kukas/48Knobs/pcb/48knobs_schematics.pdf

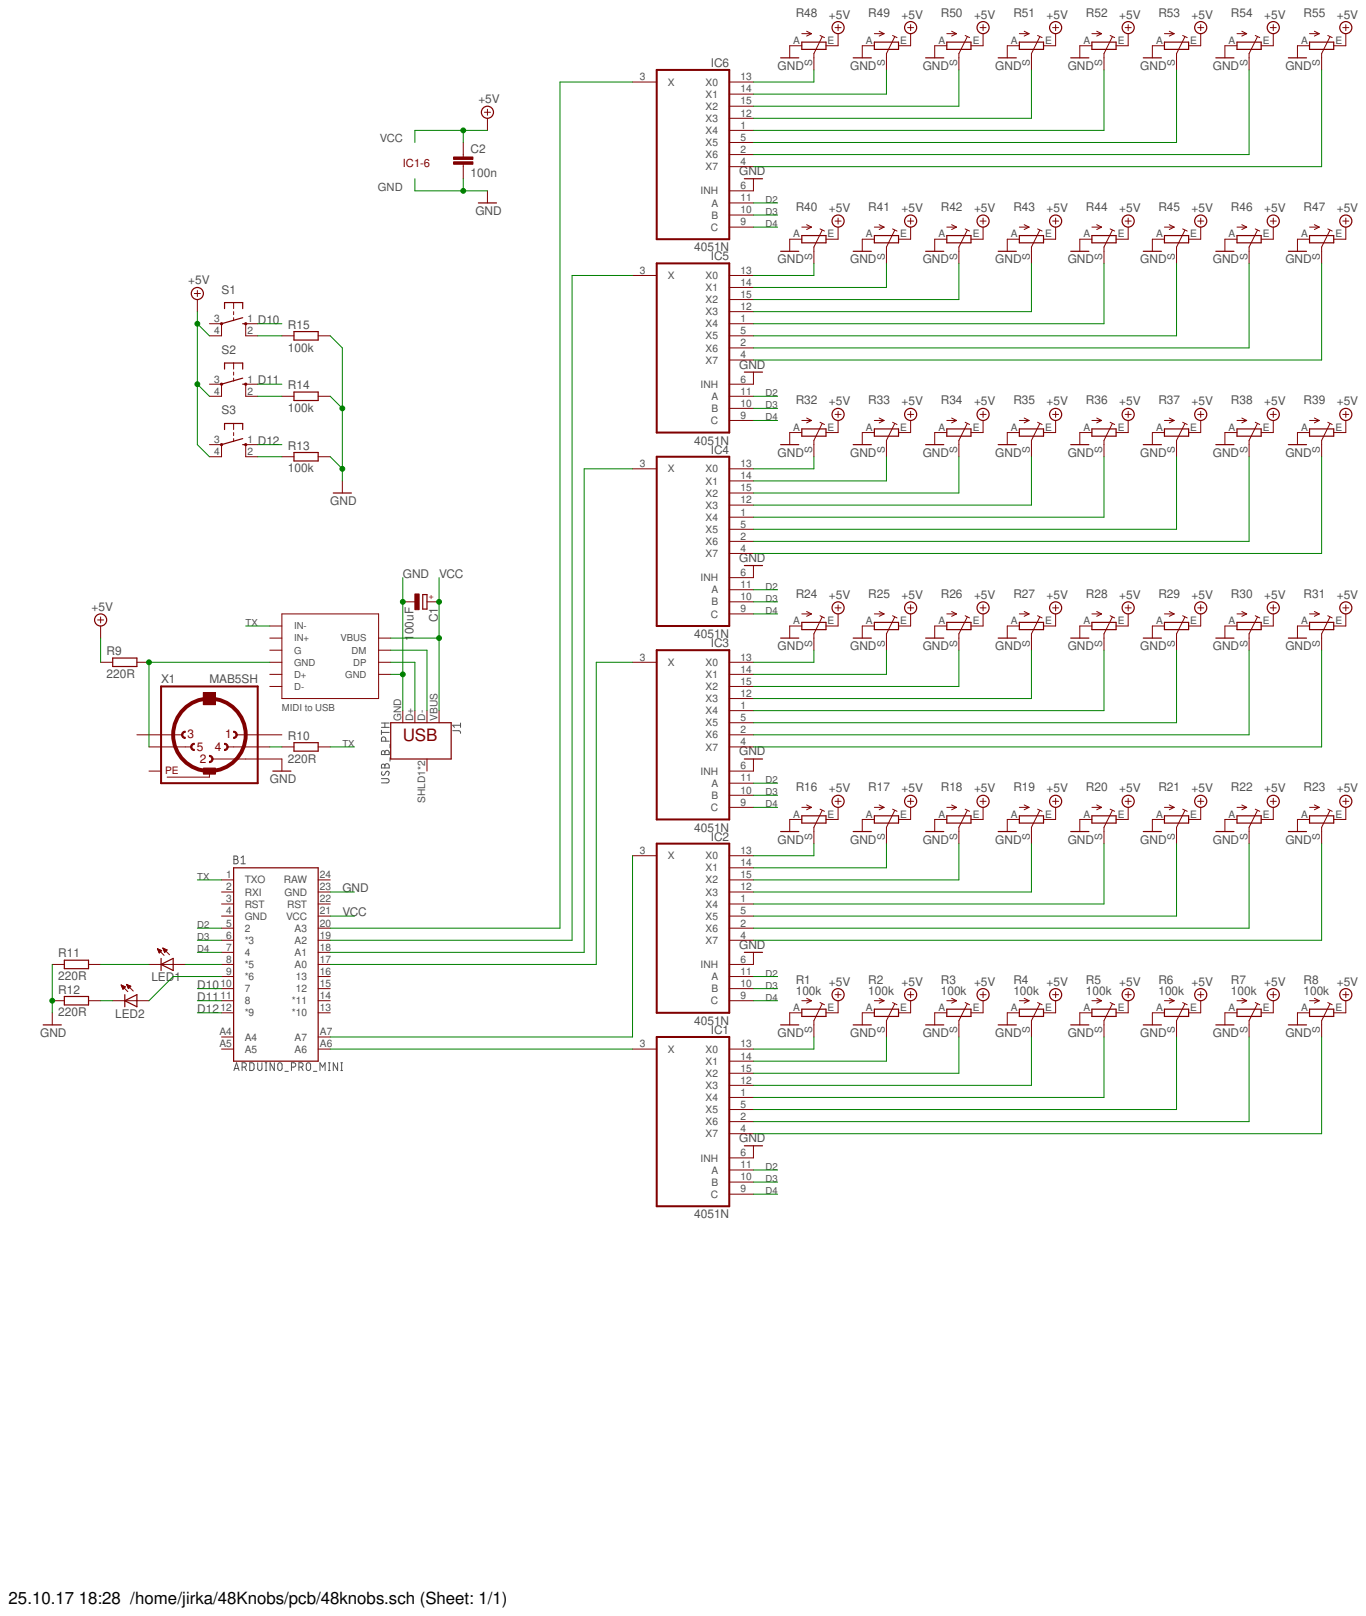
[picture p3: page 1]

25.10.17 18:28 /home/jirka/48Knobs/pcb/48knobs.sch (Sheet: 1/1)
