kukas/48Knobs/(list of files, drawings)

Other design files:
pcb/48knobs_pcb.lay6
