kukas/48Knobs/pcb/48knobs_schematics.sch

## EAGLE design pcb/48knobs_schematics.sch (2017-10-25)

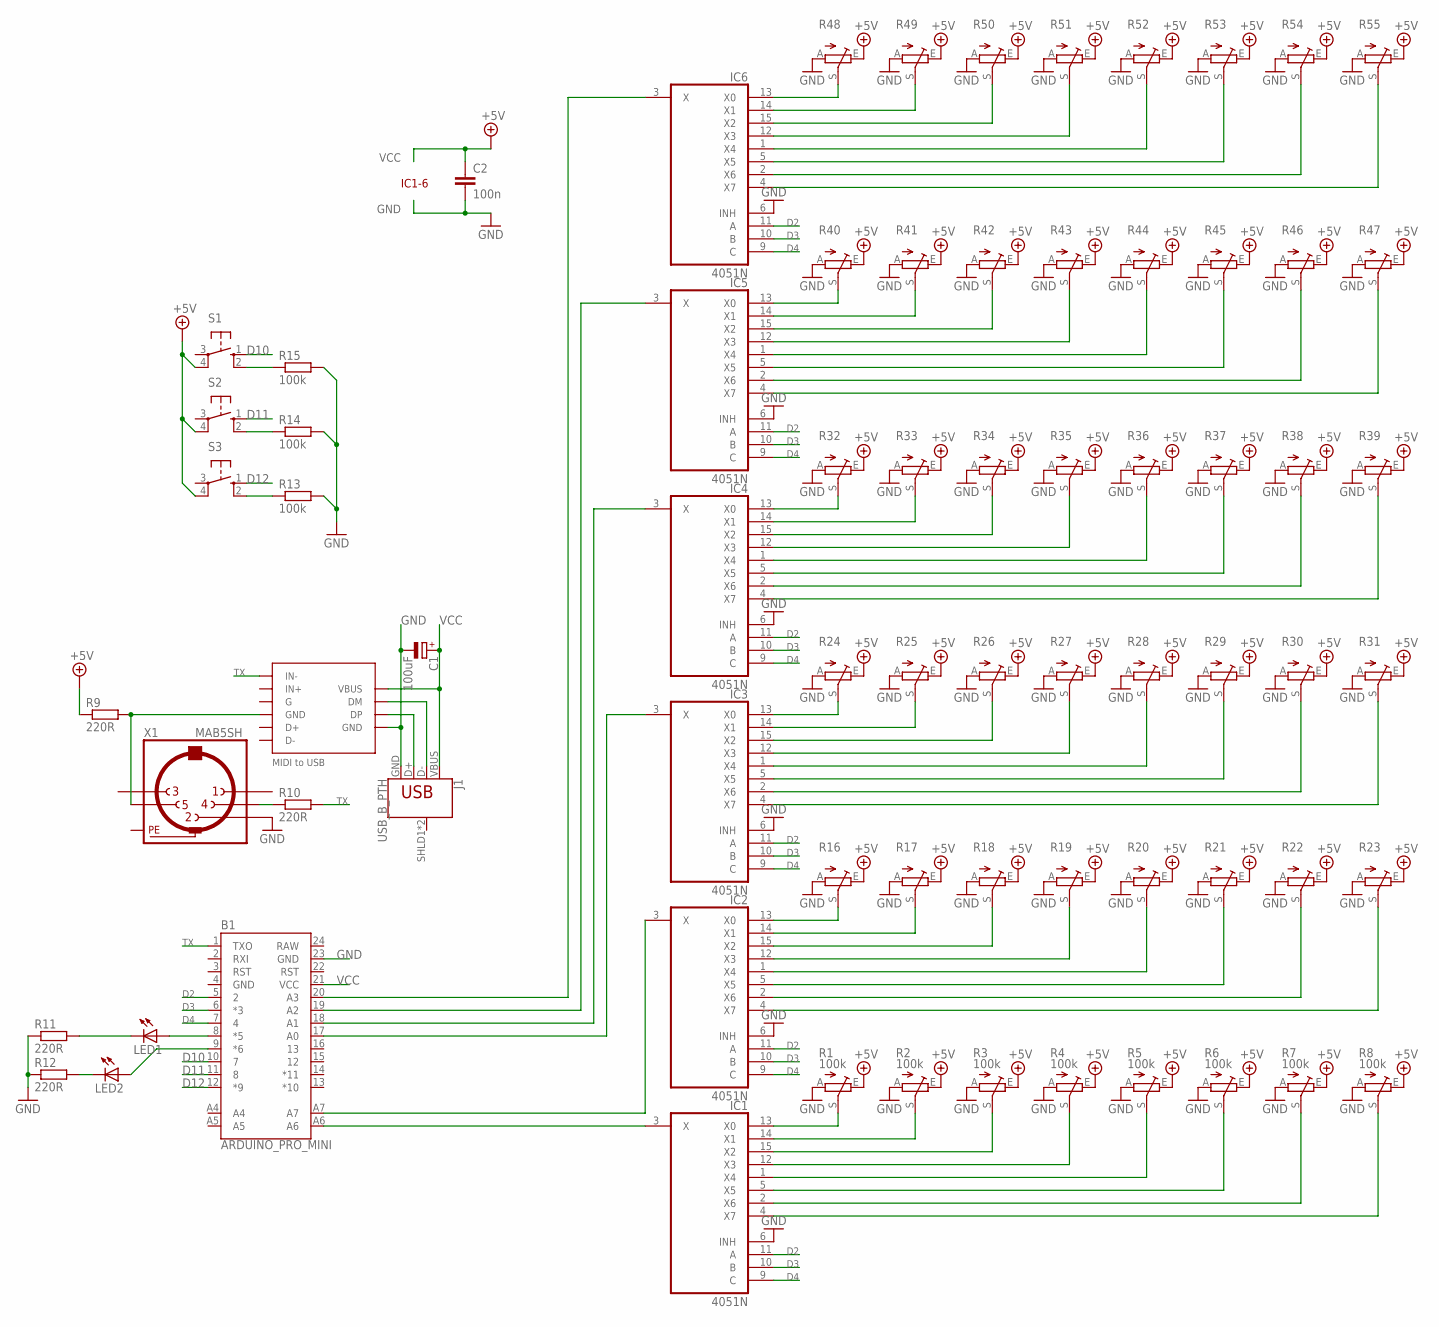
[picture p4: schematic 48knobs_schematics.sch]

Parts:
B1: ARDUINO_PRO_MINI
C1: 100uF; E1,8-4
C2: 100n; C2.5-3
IC1, IC2, IC3, IC4, IC5, IC6: 4051N; DIL16
J1: USB_B_PTH; USB-B-PTH
LED1, LED2: LED3MM
R1, R2, R3, R4, R5, R6, R7, R8: 100k; B25U
R9, R10, R11, R12: 220R; 0204/5
R13, R14, R15: 100k; 0204/5
R16, R17, R18, R19, R20, R21, R22, R23, R24, R25, R26, R27, R28, R29, R30, R31, R32, R33, R34, R35, R36, R37, R38, R39, R40, R41, R42, R43, R44, R45, R46, R47, R48, R49, R50, R51, R52, R53, R54, R55: TRIM_EU-B25U; B25U
S1, S2, S3: 10-XX; B3F-10XX
X1: MAB5SH

Connections:
+5V: R1.E, R2.E, R3.E, R4.E, R5.E, R6.E, R7.E, R8.E, R9.1, R16.E, R17.E, R18.E, R19.E, R20.E, R21.E, R22.E, R23.E, R24.E, R25.E, R26.E, R27.E, R28.E, R29.E, R30.E, R31.E, R32.E, R33.E, R34.E, R35.E, R36.E, R37.E, R38.E, R39.E, R40.E, R41.E, R42.E, R43.E, R44.E, R45.E, R46.E, R47.E, R48.E, R49.E, R50.E, R51.E, R52.E, R53.E, R54.E, R55.E, S1.4 (P1), S2.4 (P1), S3.4 (P1)
D2: B1.5 (2), IC1.11 (A), IC2.11 (A), IC3.11 (A), IC4.11 (A), IC5.11 (A), IC6.11 (A)
D3: B1.6 (*3), IC1.10 (B), IC2.10 (B), IC3.10 (B), IC4.10 (B), IC5.10 (B), IC6.10 (B)
D4: B1.7 (4), IC1.9 (C), IC2.9 (C), IC3.9 (C), IC4.9 (C), IC5.9 (C), IC6.9 (C)
D10: B1.10 (7), S1.1 (S)
D11: B1.11 (8), S2.1 (S)
D12: B1.12 (*9), S3.1 (S)
GND: B1.23 (GND), C1.-, C2.2, IC1.6 (INH), IC2.6 (INH), IC3.6 (INH), IC4.6 (INH), IC5.6 (INH), IC6.6 (INH), J1.GND, R1.A, R2.A, R3.A, R4.A, R5.A, R6.A, R7.A, R8.A, R11.1, R12.1, R13.2, R14.2, R15.2, R16.A, R17.A, R18.A, R19.A, R20.A, R21.A, R22.A, R23.A, R24.A, R25.A, R26.A, R27.A, R28.A, R29.A, R30.A, R31.A, R32.A, R33.A, R34.A, R35.A, R36.A, R37.A, R38.A, R39.A, R40.A, R41.A, R42.A, R43.A, R44.A, R45.A, R46.A, R47.A, R48.A, R49.A, R50.A, R51.A, R52.A, R53.A, R54.A, R55.A, X1.2
unnamed: IC1.13 (X0), R1.S
unnamed: IC1.14 (X1), R2.S
unnamed: IC1.15 (X2), R3.S
unnamed: IC1.12 (X3), R4.S
unnamed: IC1.1 (X4), R5.S
unnamed: IC1.5 (X5), R6.S
unnamed: IC1.2 (X6), R7.S
unnamed: IC1.4 (X7), R8.S
unnamed: R9.2, X1.5
unnamed: R10.1, X1.4
unnamed: B1.8 (*5), LED1.A
unnamed: B1.9 (*6), LED2.A
unnamed: LED1.K (C), R11.2
unnamed: LED2.K (C), R12.2
unnamed: IC2.13 (X0), R16.S
unnamed: R15.1, S1.2 (S1)
unnamed: R14.1, S2.2 (S1)
unnamed: R13.1, S3.2 (S1)
unnamed: IC2.14 (X1), R17.S
unnamed: IC2.15 (X2), R18.S
unnamed: IC2.12 (X3), R19.S
unnamed: IC2.1 (X4), R20.S
unnamed: IC2.5 (X5), R21.S
unnamed: IC2.2 (X6), R22.S
unnamed: IC2.4 (X7), R23.S
unnamed: IC3.13 (X0), R24.S
unnamed: IC3.14 (X1), R25.S
unnamed: IC3.15 (X2), R26.S
unnamed: IC3.12 (X3), R27.S
unnamed: IC3.1 (X4), R28.S
unnamed: IC3.5 (X5), R29.S
unnamed: IC3.2 (X6), R30.S
unnamed: IC3.4 (X7), R31.S
unnamed: IC4.13 (X0), R32.S
unnamed: IC4.14 (X1), R33.S
unnamed: IC4.15 (X2), R34.S
unnamed: IC4.12 (X3), R35.S
unnamed: IC4.1 (X4), R36.S
unnamed: IC4.5 (X5), R37.S
unnamed: IC4.2 (X6), R38.S
unnamed: IC4.4 (X7), R39.S
unnamed: IC5.13 (X0), R40.S
unnamed: IC5.14 (X1), R41.S
unnamed: IC5.15 (X2), R42.S
unnamed: IC5.12 (X3), R43.S
unnamed: IC5.1 (X4), R44.S
unnamed: IC5.5 (X5), R45.S
unnamed: IC5.2 (X6), R46.S
unnamed: IC5.4 (X7), R47.S
unnamed: IC6.13 (X0), R48.S
unnamed: IC6.14 (X1), R49.S
unnamed: IC6.15 (X2), R50.S
unnamed: IC6.12 (X3), R51.S
unnamed: IC6.1 (X4), R52.S
unnamed: IC6.5 (X5), R53.S
unnamed: IC6.2 (X6), R54.S
unnamed: IC6.4 (X7), R55.S
unnamed: B1.A6, IC1.3 (X)
unnamed: B1.A7, IC2.3 (X)
unnamed: B1.17 (A0), IC3.3 (X)
unnamed: B1.18 (A1), IC4.3 (X)
unnamed: B1.19 (A2), IC5.3 (X)
unnamed: B1.20 (A3), IC6.3 (X)
TX: B1.1 (TXO), R10.2
VCC: B1.21 (VCC), C1.+, C2.1, J1.VBUS

Notes on the sheet:
GND
VBUS
IN-
IN+
MIDI to USB
IC1-6
