kukas/48Knobs/(commit log)

2017-10-13 upload pcb schematics
    [48knobs_midi_controller.lay6]
2017-10-25 add schematics
    [48knobs.sch]
2017-10-25 rename + add pcb image to readme
    [48knobs_pcb.lay6, 48knobs_schematics.sch]
2017-10-26 change debug output correct analog pins
    [48knobs.ino]
2017-10-26 button handling
2017-11-12 Channel switching with LED signalization
